gaetanogit/HeltecV3_SuperSmartReset/Prototipo.jpg

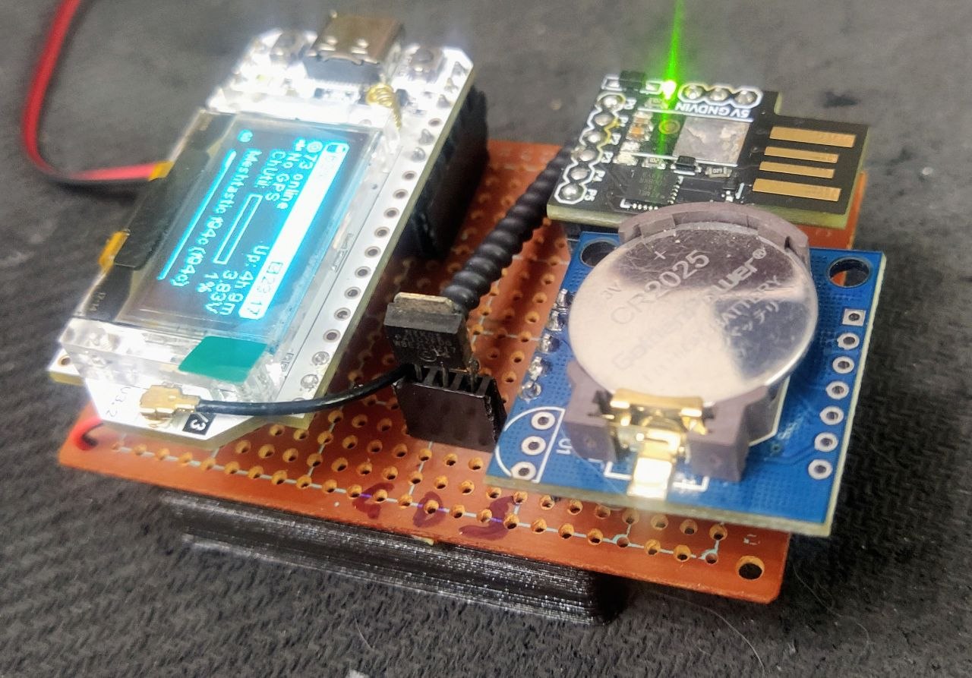
Prototipo.jpg
