gaetanogit/HeltecV3_SuperSmartReset/SuperSmartReset-MOSFET-P_bb.png

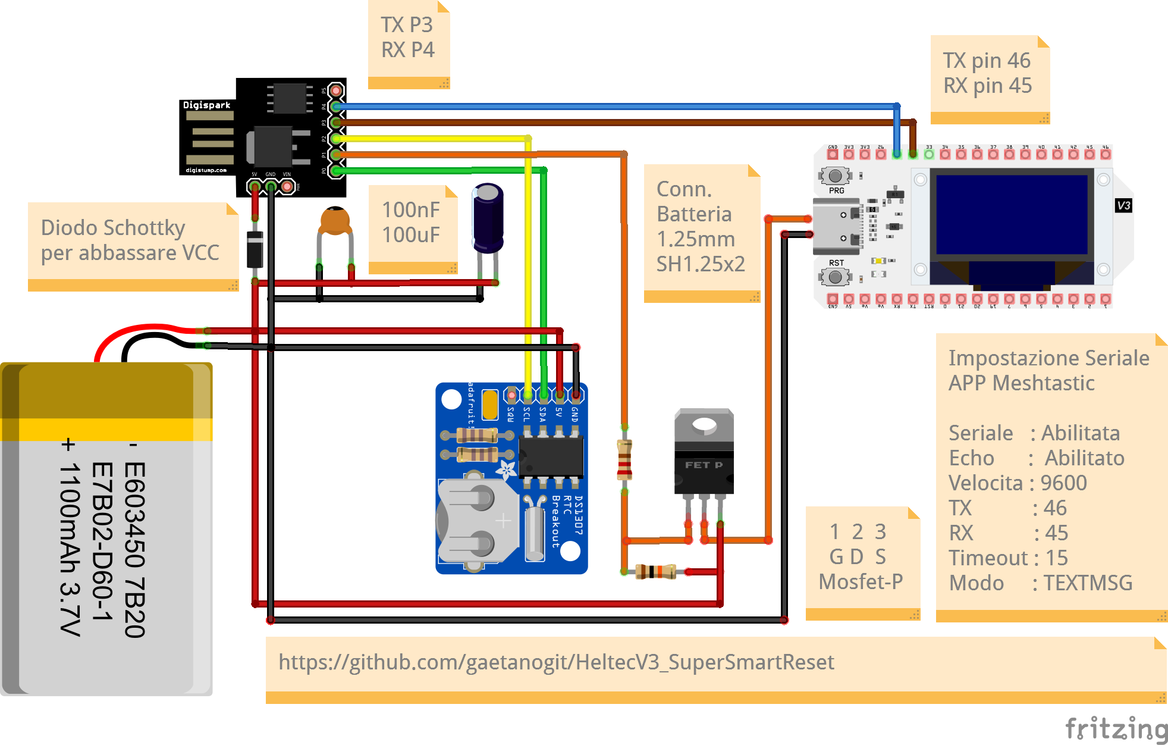
SuperSmartReset-MOSFET-P_bb.png
