gaetanogit/HeltecV3_SuperSmartReset/(commit log)

2026-07-01 Add files via upload
    modificata inizializzazione della variabile "b" a false cosi da lasciare acceso il nodo in caso all'avvio la batteria fosse nella zona grigia.
2026-07-01 Add files via upload
    Scrive/resetta i dati salvati in eeprom con dei valori di default. Usare per ripristino dati eeprom o prima inizializzazione su un Attiny85 nuovo
    [ResetPswParam1234.ino]
